JakubWojtylak/Manipulator/Raporty/Naprezenia.JPG

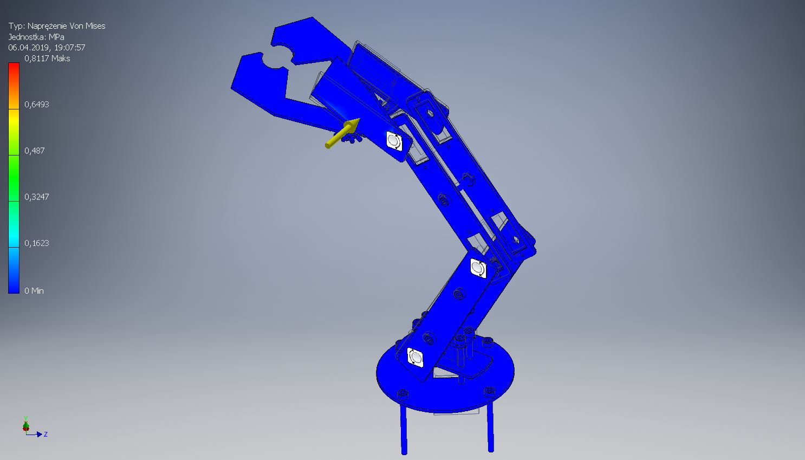
Raporty/Naprezenia.JPG
