JakubWojtylak/Manipulator/Raporty/Model.JPG

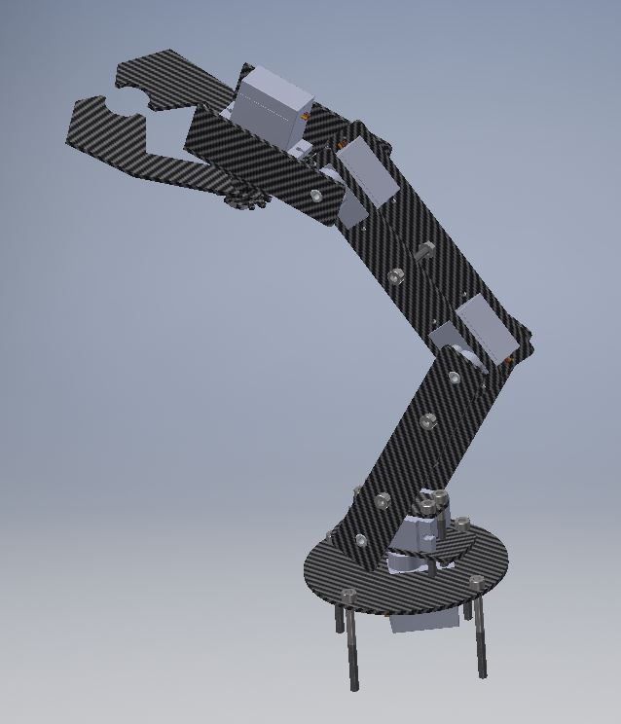
Raporty/Model.JPG
