JakubWojtylak/Manipulator/Raporty/raport wstepny.pdf

Projekt zespołowy

Maniputor

Piotr Bogdoł

Grzegorz Masłowski

Michał Piotrowicz

Jakub Wojtylak

14 marca 2019

## Spis treści

1 Problem projektu | 2
2 Plan pracy | 3
3 Doręczenie | 5
4 Budżet | 5
5 Zarządzanie projektem | 5
6 Zespół | 6

## 1 Problem projektu

Przedmiotem projektu jest stworzenie od podstaw manipulatora o 4 stopniach swobody. Urządzenie powinno być w stanie wykonać prostą operację ”pick and place”. Manipulator będzie wykonywać czynność pobierania obiektu tylko wtedy, gdy ten będzie ustawiony w odpowiednim miejscu. Przedmiot zostanie dostarczony także do zadanego punktu. Połączenie ramienia i miejsc pobierania oraz zwrotu obiektu przenoszonego będzie wymagało przygotowania platformy wyznaczającej przestrzeń roboczą urządzenia.

Mechanicznie konstrkcja będzie oparta na wyfrezowanych elementach wykonanych z laminatu. Człony manipulatora będą połączone serwomechanizmami modelarskimi o masie 10g. Do wykończenia efektora powinien być użyty materiał o optymalnej przyczepności, tzn. takiej, która pozwoli na swobodne podnoszenie i odkładanie obiektu. Można będzie użyć odpowiedniej mieszanki silikonu formierskiego lub poliuretanu. Narzędzia, frezarka CNC, drukarka 3D oraz pomieszczenie warsztatowe użytkowane na potrzeby projektu zostaną udostępnione przez KNR ”KoNaR”.

Część elektroniczna projektu będzie oparta o mikrokontroler firmy ST. Układ zasilany będzie akumulatorem litowo - polimerowym o napięciu nominalnym 7,4V. Płytka drukowana zostanie zaprojektowana w ramach projektu. Głównym założeniem będzie minimalizacja przestrzeni zajmowanej przez nią.

Innym problemem projektowym będzie stworzenie odpowiednich algorytmów sterowania przekładających ustawienia kolejnych serwomechanizmów na pozycję efektora w przestrzeni roboczej.

Raporty z kolejnych etapów projektu, archiwum z oprogramowaniem, dokumentacja mechaniczna i elektroniczna, zdjęcia konstrukcji, instrukcja użytkowania oraz informacje o zespole zostaną systematycznie upowszechniane na storzonym do tego celu serwisie www.

## 2 Plan pracy

### 2.1 Podział na zadania

W projekcie pomniejsze zadania podzielono na grupy dotyczące:

- Mechaniki
- Elektrniki
- Programowania sterownika
- Zarządzania projektem

Podzadania wydzielono miedzy członków zespołu projektowego i wydzielono czas na wykonanie każdego z nich:

Zadanie | Data roz-poczęcia | Data za-kończenia | Osoba(-y)
Projekt mechaniki ramienia i chwytaka | 18.03.2019 | 29.03.2019 | Michał Piotrowicz
Wykonanie elementów z laminatu i złożenie członów manipulatora | 30.03.2019 | 8.04.2019 | Grzegorz Masłowski, Michał Piotrowicz
Projekt platformy urządzenia | 3.04.2019 | 14.04.2019 | Michał Piotrowicz, Jakub Wojtylak
Wykonanie platformy | 15.04.2019 | 30.04.2019 | Piotr Bogdoł, Michał Piotrowicz, Jakub Wojtylak
Utworzenie połączeń elektrycznych w fizycznym urządzeniu | 29.04.2019 | 7.05.2019 | Piotr Bogdoł, Michał Piotrowicz, Grzegorz Masłowski
Projekt PCB | 18.03.2019 | 9.04.2019 | Grzegorz Masłowski
Wykonanie PCB | 13.04.2019 | 25.04.2019 | Grzegorz Masłowski, Jakub Wojtylak
Podłączenie płytek drukowanych z czujnikami położenia obiektu | 26.04.2019 | 7.05.2019 | Piotr Bogdoł, Grzegorz Masłowski, Michał Piotrowicz
Program obsługujący ruch manipulator w przestrzeni | 30.03.2019 | 13.05.2019 | Piotr Bogdoł, Jakub Wojtylak
Automatyzacja -reakcja na dane z czujników | 19.04.2019 | 4.06.2019 | Piotr Bogdoł, Jakub Wojtylak
Realizacja zamówień | 23.03.2019 | 24.04.2019 | Grzegorz Masłowski, Michał Piotrowicz
Utrzymanie strony internetowej z dokumentacją | 30.03.2019 | 4.06.2019 | Piotr Bogdoł, Jakub Wojtylak

### 2.2 Wykres Gantta

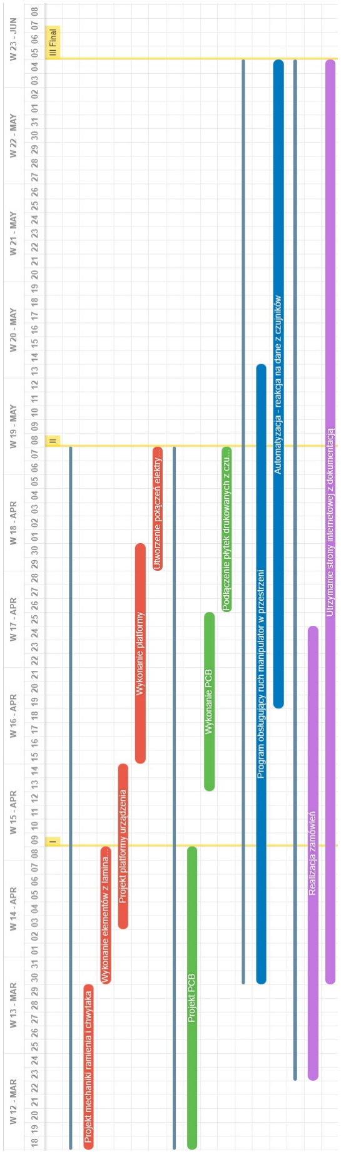
[picture p7: figure]

## 3 Doręczenie

Wydzielono nastepujące kamienie milowe:

I raport częściowy do 9.04.2019:

- Gotowe ramię manipulatora wraz z efektorem,
- Prezentacja projektu PCB,
- Wstępny projekt platformy.

II raport częściowy do 8.05.2019:

- Ukończona część mechaniczna projektu - manipulator wraz z platformą do podnoszenia i odkładania obiektu,
- Przedstawienie gotowej części elektronicznej.

III raport częściowy do 5.06.2019 będący jednocześnie raportem końcowym:

- Podsumowanie całości projektu.
- Dokumentacja gotowego urządzenia, instrukcja uruchamiania i obsługi.

## 4 Budżet

Projekt finansowany zostanie ze środków KCiR oraz własnych. Część kosztów poniesionych przez używanie elektronarzędzi poniesie KNR ”KoNaR”. Zaplanowano ramowy kosztorys przedstawiony w tabeli poniżej.

Pozycja | Kwota
5 x serwomechanizm Redox S90 MG | 110,00 zł
Laminat jednostronny 1,6 mm | 30,00 zł
Drobnica elektroniczna i mechaniczna | 300,00 zł
Suma | 440,00 zł

Tabela 1: Poglądowy kosztorys projektu

## 5 Zarządzanie projektem

- Pracę członków zespołu nadzoruje koordynator.
- Potencjalne konflikty rozwiązywane są ostateczną decyzją koordynatora.
- Spotkania zespołu będą odbywały się w każdą środę w ramach zajęć. Omawiane na nich będą postępy w pracach i podejmowane decyzje na temat kolejnych etapów projektu.
- Porządek zadań ustalany jest w oparciu o system Trello.
- Przydział czasu na poszczególne zadania opisuje wykres Gantta.
- Używany będzie system kontroli wersji Git. Obsługiwać będzie repozytorium Bitbucket.
- Prawa własności intelektualnej należą do wszystkich członków zespołu projektowego. Wszyscy zgadzają się na udostępnienie swojej części pracy na rzecz dalszego rozwoju projektu przez jednego z uczestników.

## 6 Zespół

Imię i nazwisko | Nr indeksu | Funkcje
Michał Piotrowicz | 235759 | koordynator projektu projekt i wykonanie mechaniki dobór części napędu
Piotr Bogdoł | 235244 | programowanie sterownika utrzymanie strony www wykończenie częsci mechanicznej i elektronicznej
Grzegorz Masłowski | 235121 | projekt i wykonanie elektroniki dobór części elektronicznych, wykonanie mechaniki
Jakub Wojtylak | 235248 | programowanie sterownika utrzymanie strony www wykończenie częsci mechanicznej i elektronicznej

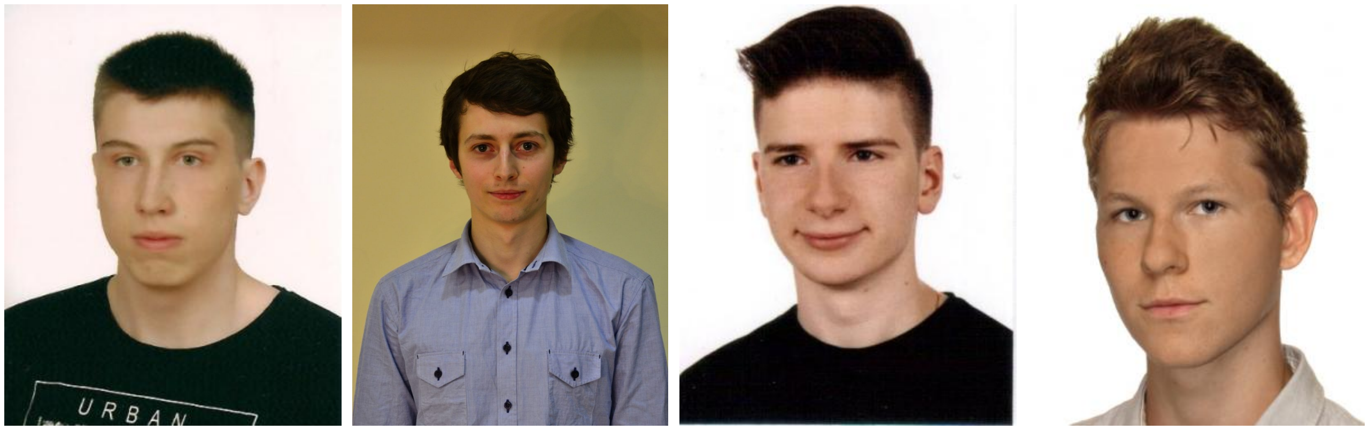
[picture p8: figure]

Piotr Bogdoł | Gregorz Masłowski | Michał Piotrowicz | Jakub Wojtylak
