JakubWojtylak/Manipulator/Oprogramowanie/Manipulator/Dox/html/group__stm32f0xx__system.png

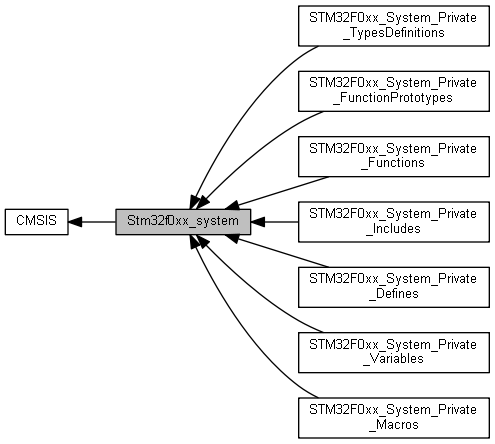
Oprogramowanie/Manipulator/Dox/html/group__stm32f0xx__system.png
