JakubWojtylak/Manipulator/Oprogramowanie/Manipulator/Dox/html/main_8c_a5a7834ccd55982ba2f868a6da96ce1ab_cgraph.png

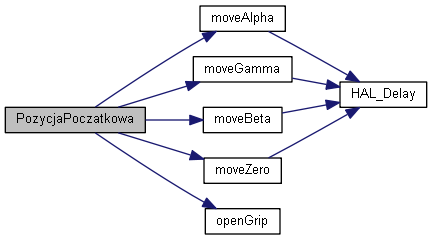
Oprogramowanie/Manipulator/Dox/html/main_8c_a5a7834ccd55982ba2f868a6da96ce1ab_cgraph.png
