JakubWojtylak/Manipulator/Oprogramowanie/Manipulator/Dox/html/main_8c_a9da5be2e36ac953449e0dc9610b75dd7_icgraph.png

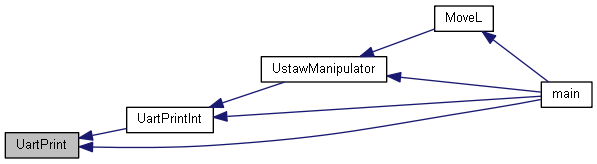
Oprogramowanie/Manipulator/Dox/html/main_8c_a9da5be2e36ac953449e0dc9610b75dd7_icgraph.png
