JakubWojtylak/Manipulator/Oprogramowanie/Manipulator/Dox/html/main_8c_a1730ffe1e560465665eb47d9264826f9_icgraph.png

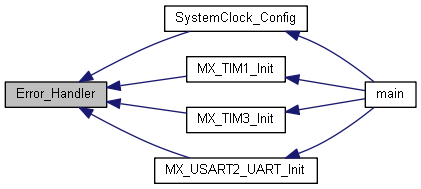
Oprogramowanie/Manipulator/Dox/html/main_8c_a1730ffe1e560465665eb47d9264826f9_icgraph.png
