JakubWojtylak/Manipulator/Oprogramowanie/Manipulator/Dox/html/main_8c_a6615caa72d2d9399c4b4fad9040e5aa1_icgraph.png

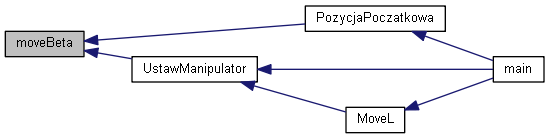
Oprogramowanie/Manipulator/Dox/html/main_8c_a6615caa72d2d9399c4b4fad9040e5aa1_icgraph.png
