JakubWojtylak/Manipulator/Oprogramowanie/Manipulator/Dox/html/main_8c_a550764bc49c9ad450d16d052c466e46c_cgraph.png

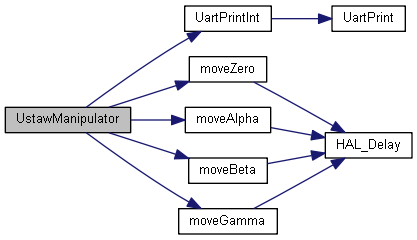
Oprogramowanie/Manipulator/Dox/html/main_8c_a550764bc49c9ad450d16d052c466e46c_cgraph.png
