JakubWojtylak/Manipulator/Oprogramowanie/Manipulator/Dox/html/main_8c_a840291bc02cba5474a4cb46a9b9566fe_cgraph.png

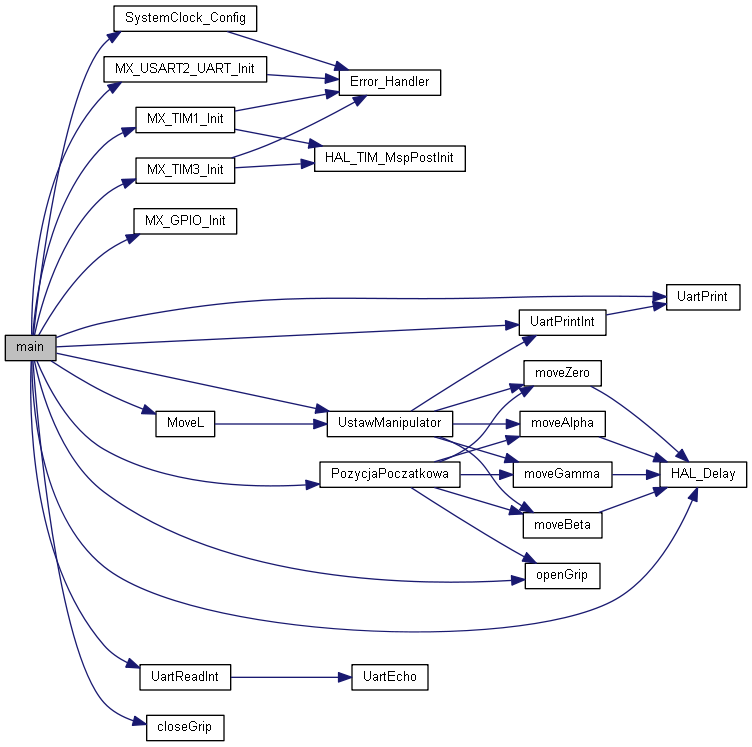
Oprogramowanie/Manipulator/Dox/html/main_8c_a840291bc02cba5474a4cb46a9b9566fe_cgraph.png
