JakubWojtylak/Manipulator/Oprogramowanie/Manipulator/Dox/html/main_8c_a988080b4ceeb1e7d6467b02994be79b6_cgraph.png

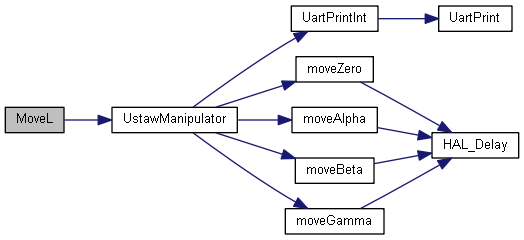
Oprogramowanie/Manipulator/Dox/html/main_8c_a988080b4ceeb1e7d6467b02994be79b6_cgraph.png
