JakubWojtylak/Manipulator/Oprogramowanie/Manipulator/Dox/html/main_8c_aef87d3fec667bb34c418f5687e8204c1_icgraph.png

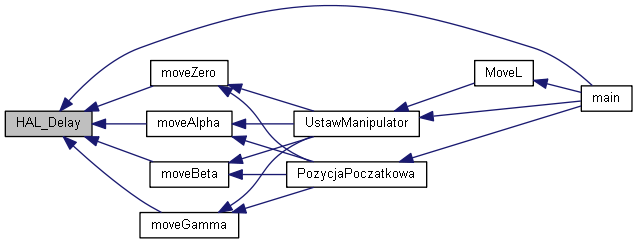
Oprogramowanie/Manipulator/Dox/html/main_8c_aef87d3fec667bb34c418f5687e8204c1_icgraph.png
