JakubWojtylak/Manipulator/Raporty/gantt.jpg

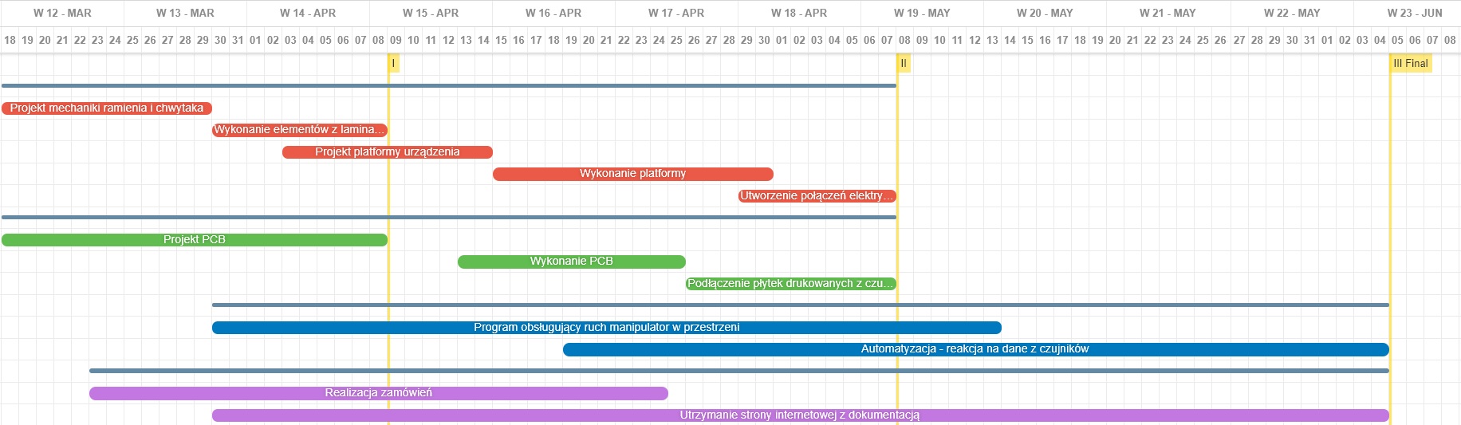
Raporty/gantt.jpg
