JakubWojtylak/Manipulator/Machanika/Servo-MG90S.SLDPRT

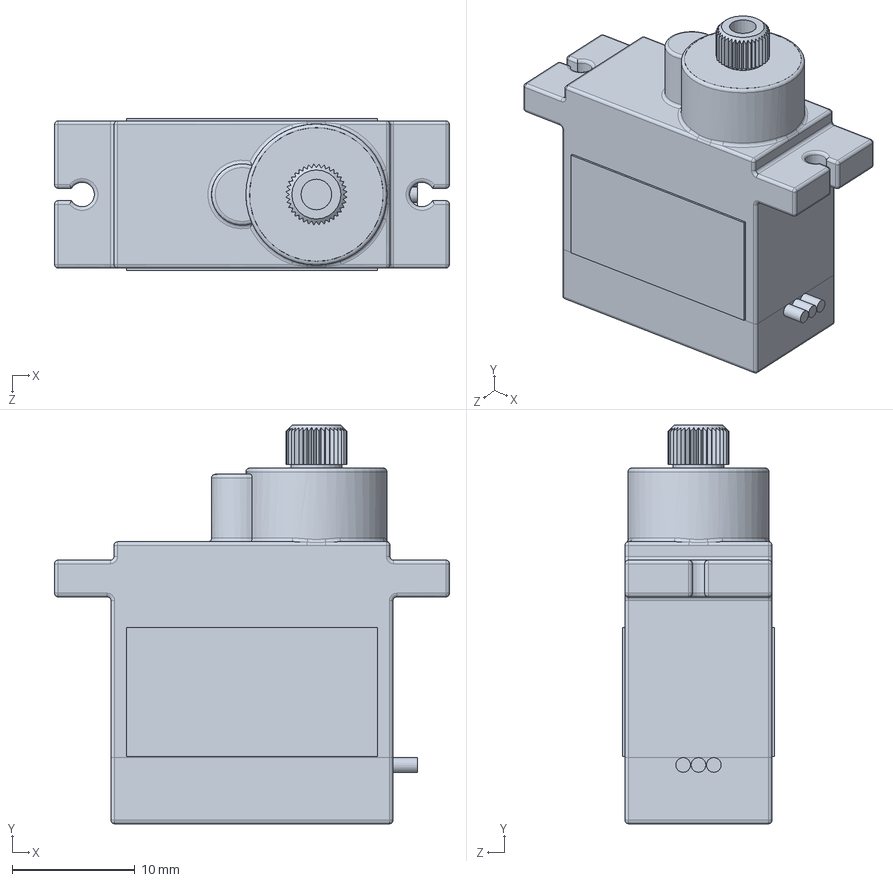
[picture p20: CAD file, 2020-03-28]
Machanika/Servo-MG90S.SLDPRT
32.2 x 32.5 x 12.4 mm
