JakubWojtylak/Manipulator/(list of files, cad)

Other CAD files:
Machanika/dopodniesienia1.ipt
Machanika/dystansik.ipt
Machanika/efektor szczypce1.ipt
Machanika/efektor zebatka1.ipt
Machanika/manipulator.iam
Machanika/mocowanie do podstawy2.ipt
Machanika/mocowanie ostatniego serwa.ipt
Machanika/podstawa1.ipt
Machanika/podstawa2.ipt
Machanika/ramie1a.ipt
Machanika/ramie2.ipt
Machanika/ramie3.ipt
Machanika/zawiasik.ipt
