JakubWojtylak/Manipulator/Elektronika/PCB_manipulator.kicad_pcb

## KiCad design Elektronika/PCB_manipulator.kicad_pcb (2020-03-28)

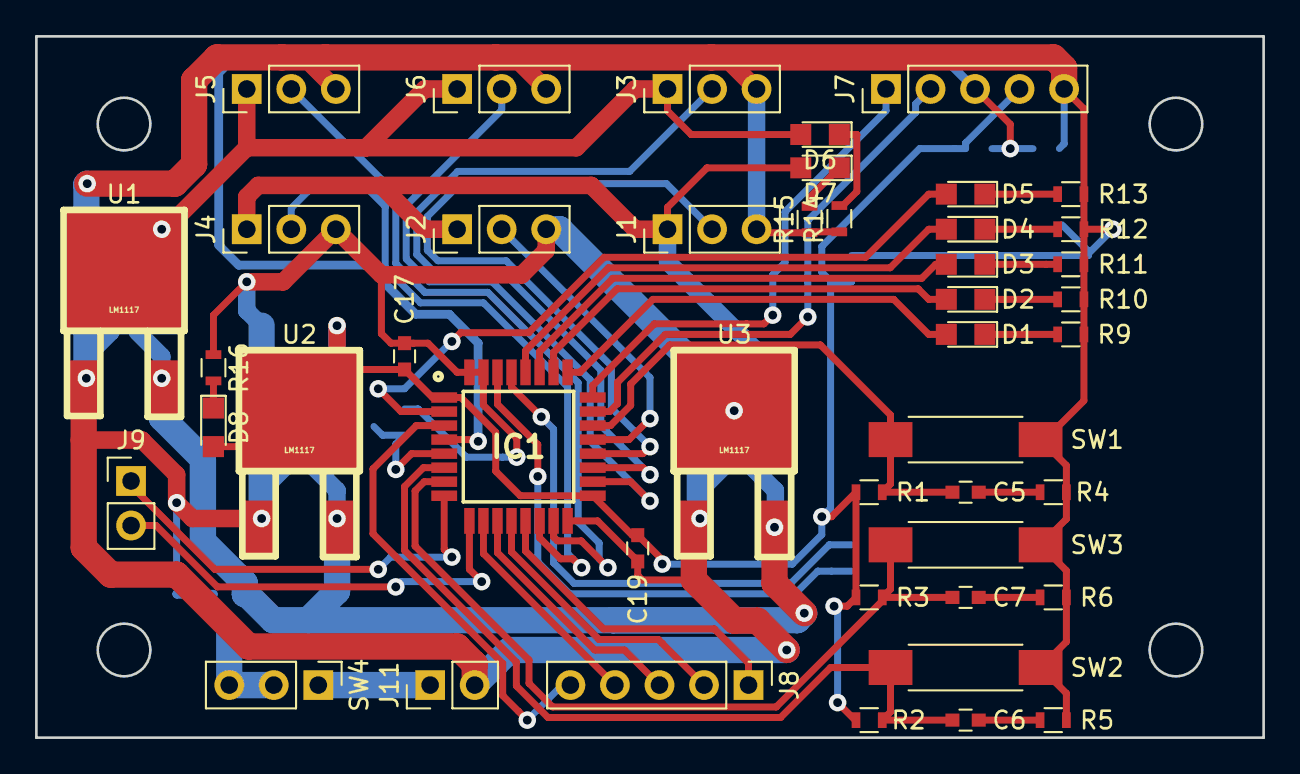
[picture p21: board PCB_manipulator.kicad_pcb from above]

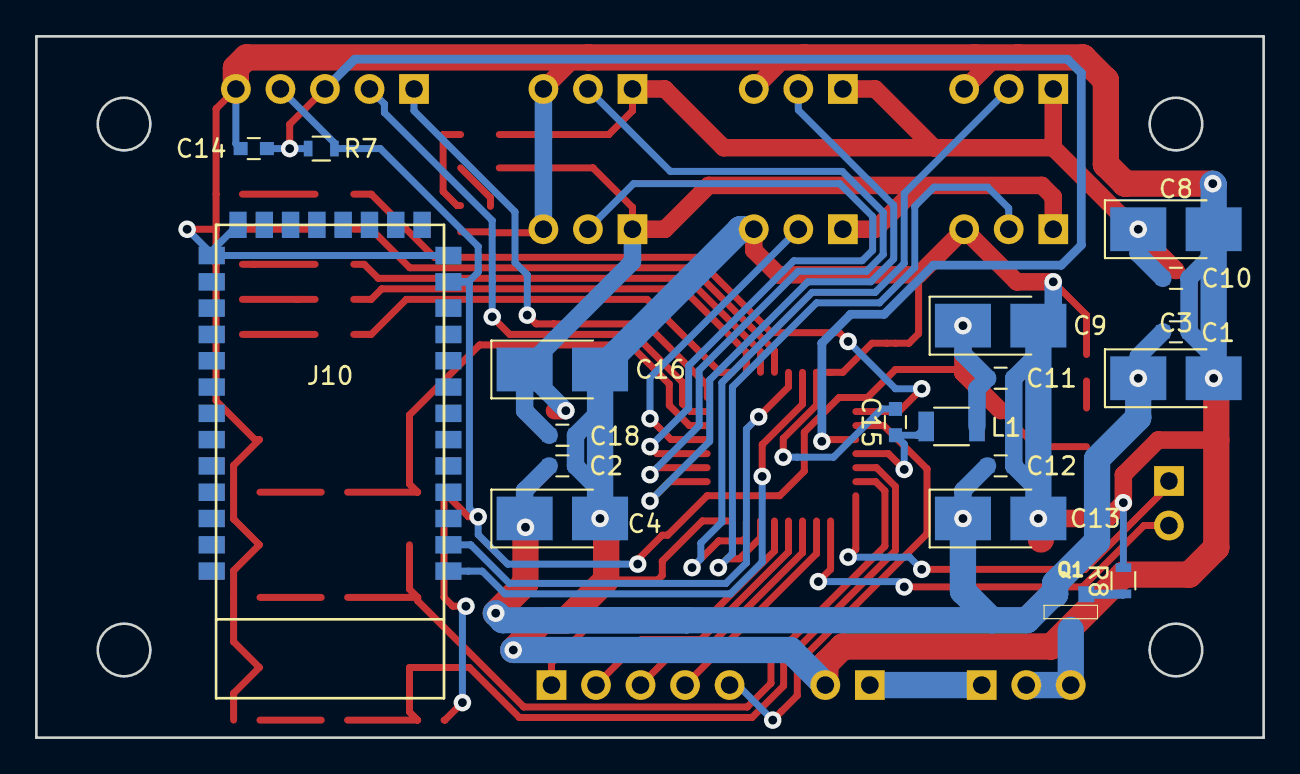
[picture p22: board PCB_manipulator.kicad_pcb from below]

Board: 2 copper layers, 70.0 x 40.0 mm, 64 parts (19 on the bottom side), 46 nets.

Parts:
C1, C2, C5, C6, C7, C10, C11, C12, C14, C15, C17, C18, C19: 100nF; C_0603
C3, C4, C8, C9, C13, C16: 10uF; CP_Tantalum_Case-B_EIA-3528-21_Hand
D1, D2, D3, D4, D5, D6, D7, D8: LED; LED_0805
IC1: STM32F051K8T6; QFP80P900X900X160-32N
J1, J2, J3, J4, J5, J6: Conn_01x03; Pin_Header_Straight_1x03_Pitch2.54mm
J7, J8: Conn_01x05; Pin_Header_Straight_1x05_Pitch2.54mm
J9, J11: Conn_01x02; Pin_Header_Straight_1x02_Pitch2.54mm
J10: Conn_01x34; HC-06
L1: L; L_1206
Q1: Q_PMOS_DGS; SOT23EBC
R1, R2, R3: 4,7k; R_0603
R4, R5, R6: 100; R_0603
R7: 100k; R_0603
R8: 1k; R_0603
R9, R10, R11, R12, R13, R14, R15, R16: 330R; R_0603
SW1, SW2, SW3: SW_Push; SW_SPST_REED_CT05-XXXX-G1
SW4: SW_SPDT; Pin_Header_Straight_1x03_Pitch2.54mm
U1, U2, U3: LM1117; LM1117_TO-252

Connections:
5V1: C8.1, C10.1, D6.2, J3.1, J5.1, J6.1, U1.2
5V2: C16.1, C18.1, D7.2, J1.1, J2.1, J4.1, U3.2
+3V3: C9.1, C11.1, C17.1, C19.2, D8.2, IC1.1, IC1.17, J7.4, J10.12, L1.2, R1.1, R2.1, R3.1, R7.2, U2.2
ADC1: IC1.13, J8.1
ADC2: IC1.12, J8.2
ADC3: IC1.11, J8.3
ADC4: IC1.10, J8.4
BT_RX: IC1.30, J10.1
BT_TX: IC1.29, J10.2
BUTTON1: C5.2, IC1.22, R1.2, SW1.1
BUTTON2: C7.2, IC1.7, R3.2, SW3.1
BUTTON3: C6.2, IC1.6, R2.2, SW2.1
GND: C1.2, C2.2, C3.2, C4.2, C8.2, C9.2, C10.2, C11.2, C12.2, C13.2, C14.2, C15.2, C16.2, C17.2, C18.2, C19.1, IC1.16, IC1.31, IC1.32, J1.3, J2.3, J3.3, J4.3, J5.3, J6.3, J7.5, J10.13, J10.21, J10.22, J11.2, R4.1, R5.1, R6.1, R8.2, R9.1, R10.1, R11.1, R12.1, R13.1, R14.1, R15.1, R16.1, SW1.2, SW2.2, SW3.2, U1.3, U2.3, U3.3
LED1: D1.2, IC1.25
LED2: D2.2, IC1.26
LED3: D3.2, IC1.27
LED4: D4.2, IC1.28
LED5: D5.2, IC1.2
unnamed: C5.1, R4.2
unnamed: C6.1, R5.2
unnamed: C7.1, R6.2
unnamed: C15.1, IC1.5, L1.1
unnamed: D1.1, R9.2
unnamed: D2.1, R10.2
unnamed: D3.1, R11.2
unnamed: D4.1, R12.2
unnamed: D5.1, R13.2
unnamed: D6.1, R14.2
unnamed: D7.1, R15.2
unnamed: D8.1, R16.2
unnamed: Q1.3, SW4.2, SW4.3
unnamed: Q1.2, R8.1
OUT1: IC1.3, J8.5
PWM1: IC1.21, J2.2
PWM2: IC1.20, J1.2
PWM3: IC1.19, J3.2
PWM4: IC1.18, J6.2
PWM5: IC1.15, J5.2
PWM6: IC1.14, J4.2
RESET: C14.1, IC1.4, J7.3, R7.1
SWCLK: IC1.24, J7.1
SWDIO: IC1.23, J7.2
USART_RX: IC1.9, J9.2
USART_TX: IC1.8, J9.1
VCC: J11.1, SW4.1
VIN: C1.1, C2.1, C3.1, C4.1, C12.1, C13.1, Q1.1, U1.1, U2.1, U3.1
