JakubWojtylak/Manipulator/Oprogramowanie/Manipulator/Inc/main.h

#define LED5_Pin GPIO_PIN_0
#define LED5_GPIO_Port GPIOF
#define Button1_Pin GPIO_PIN_0
#define Button1_GPIO_Port GPIOA
#define Button2_Pin GPIO_PIN_1
#define Button2_GPIO_Port GPIOA
#define LED1_Pin GPIO_PIN_15
#define LED1_GPIO_Port GPIOA
#define LED2_Pin GPIO_PIN_3
#define LED2_GPIO_Port GPIOB
#define LED3_Pin GPIO_PIN_4
#define LED3_GPIO_Port GPIOB
#define LED4_Pin GPIO_PIN_5
#define LED4_GPIO_Port GPIOB
